TrueBlankSlate/TinyGPU/README.md

# TinyGPU

A small SIMD vector accelerator, attached to a [CVA6](https://github.com/openhwgroup/cva6) RISC-V core
as a custom coprocessor extension [(CV-X-IF)](https://docs.openhwgroup.org/projects/cva6-user-manual/01_cva6_user/CVX_Interface_Coprocessor.html), that runs 4x4 matrix operations
(`vmacc` matrix-multiply, `vadd.vv` elementwise add) on real Zynq-7000 hardware.
CVA6 issues vector-style instructions over the CV-X-IF interface; TinyGPU
decodes them, runs four ALU lanes in parallel, and writes results back to
memory over AXI.

It accepts 64-bit RISC-V Vector Extension standard instructions like `vle64.v vadd.vv vmacc.vv vse64.v `  
and operates like [ARA](https://github.com/pulp-platform/ara) in tandem with CVA6.

<p align ="center">
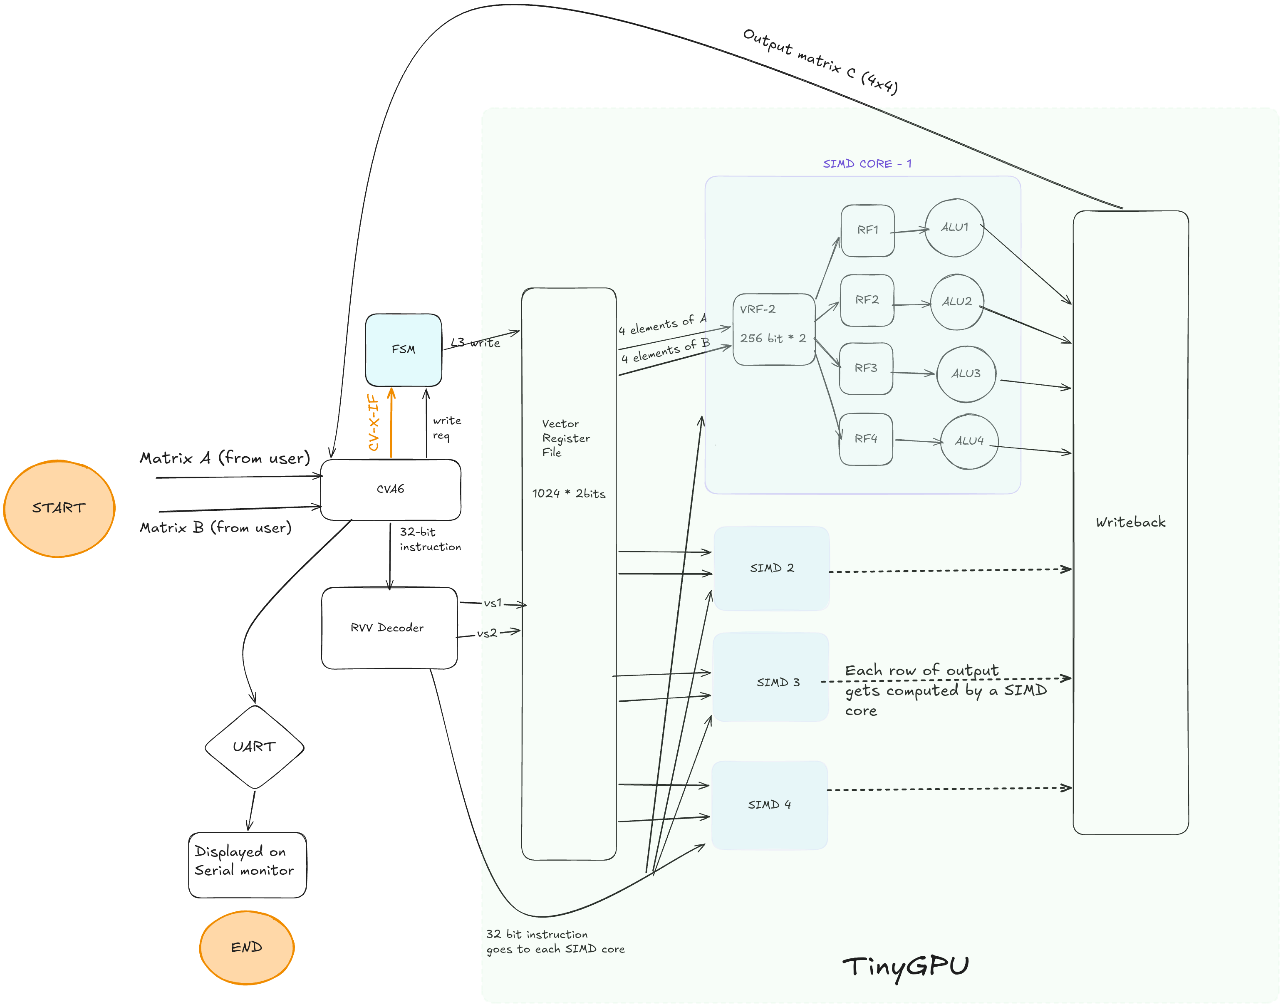
[picture p1: images/tinygpu_exacli.png]
Elaborated design

</p>

## Overview

TinyGPU is four ALU lanes (`design_1` / "the SIMD core") wrapped by a small
FSM (`tinygpu_fsm.v`) that:

- receives an offloaded instruction from CVA6 over CV-X-IF (`tinygpu_cvxif_wrap.v`,
  `cva6_sv_shim.sv`),
- pulls the operand matrices (`mat_a`, `mat_b`) into a 4-row/4-column
  register cache (`cache.v`, `register_file.v`),
- runs all 4 lanes' ALUs (`alu.v`) in parallel per pass, either as a plain
  elementwise op or, for `vmacc`, accumulating each lane's product into a
  dot-product term (`dot_reg[]` in `design_1.v`) across 4 passes to produce
  one row of a real matrix product,
- and drives an AXI4 write burst (`writeback.v`) to park the 4x4 result back
  in memory for the host to read.

The whole thing is built as a Zynq PS7 + custom PL design
(`zynq_system.bd`): CVA6 and TinyGPU live in the PL as `fpga_top`, boot
straight out of a synthesizable BRAM (`axi4_bram_slave.v`, preloaded via
`boot_image.hex`) instead of an OS, run a fixed instruction sequence (load
matrix A, `vmacc` A×A, store, `vadd.vv` A+A, store, loop), and the PS7's
ARM side (running a bare-metal Vitis app) reads the results straight out of
PL memory over the GP0 AXI port and prints them over UART.

### Workflow

1. On reset, CVA6 boots directly from `boot_image.hex` (no OS, no bootloader)
   and runs a short RISC-V program, compiled by a real `riscv64-unknown-elf-
   gcc`/`riscv-none-elf-gcc` toolchain from `fw/boot_matmul.S` (see
   [`fw/`](#fw--real-compiler-toolchain) below), that:
   - loads a 4x4 matrix `A` (64-bit elements) via a custom `vle64.v` load,
   - issues `vmacc` (matrix multiply, A × A) and stores the 4x4 result `C_mul`,
   - issues `vadd.vv` (elementwise add, A + A) and stores the 4x4 result `C_add`,
   - jumps to itself (`jal x0,0`) to park.
2. Every custom vector instruction is caught by CVA6's CV-X-IF offload
   interface and handed to TinyGPU instead of being executed on the scalar
   pipeline.
3. TinyGPU computes the result across 4 lanes/4 passes and writes it back
   over AXI4 to a fixed address in PL memory.
4. The Zynq PS7 (a bare-metal Vitis app, `vitis/main.c`) reads both result
   matrices straight out of that PL memory through the GP0 AXI aperture
   (`0x4000_0000`+) and prints them over UART:

   For vmacc.vv
   ```
   C_mul = A x A (vmacc)
   [   90  100  110  120 ]
   [  202  228  254  280 ]
   [  314  356  398  440 ]
   [  426  484  542  600 ]
   ```
   And for vadd.vv
   ```

   C_add = A + A (vadd.vv)
   [    2    4    6    8 ]
   [   10   12   14   16 ]
   [   18   20   22   24 ]
   [   26   28   30   32 ]
   ```

### Block design (Vivado)
<p align="center">
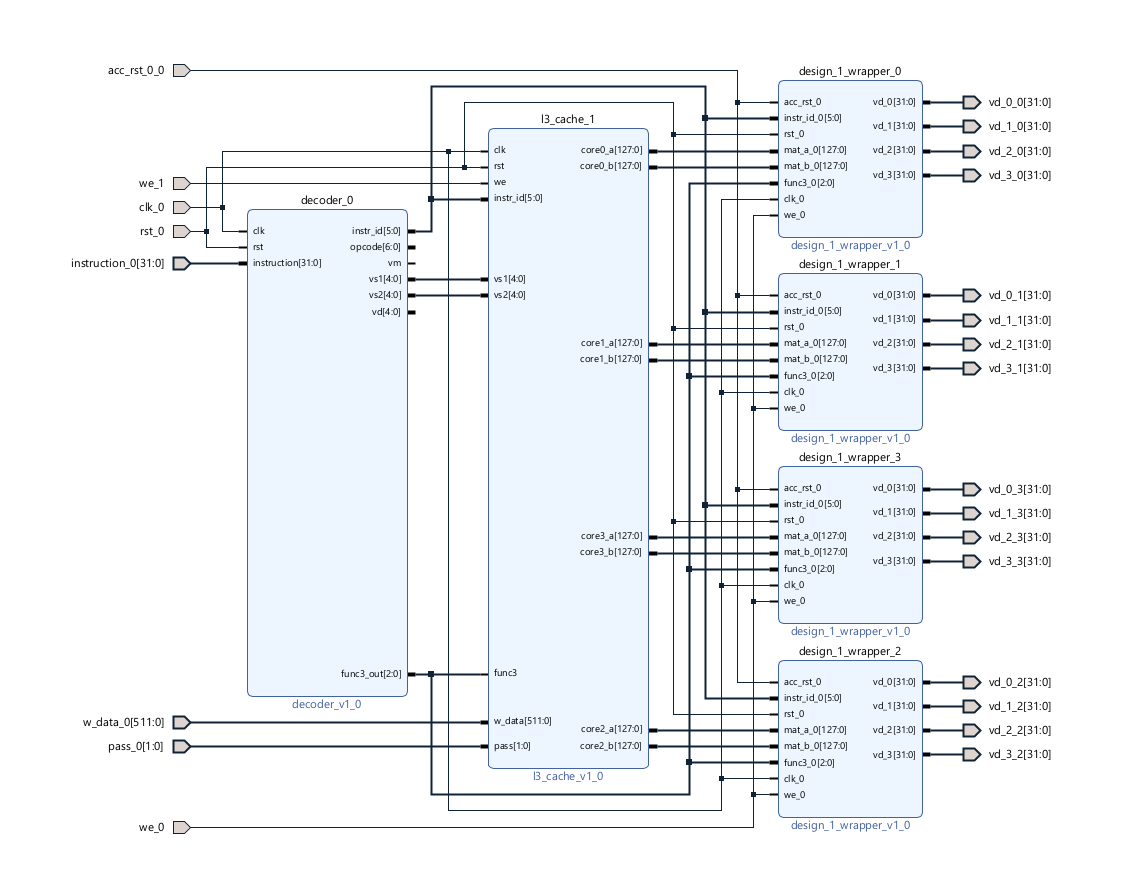
[picture p2: images/tinygpu_block_design.png]
Block Design
 </p>

PS7 is configured with the board preset, `M_AXI_GP0` enabled, and a 25MHz
FPGA clock. `fpga_top` is wired in as a plain RTL module (not packaged as an
IP), with GP0 connected **directly** to `axi4_bram_slave`'s AXI-lite-style
read port (no SmartConnect / interconnect in the datapath) so the PS7 can
read TinyGPU's result memory with the simplest possible address decode.

<p align="center">
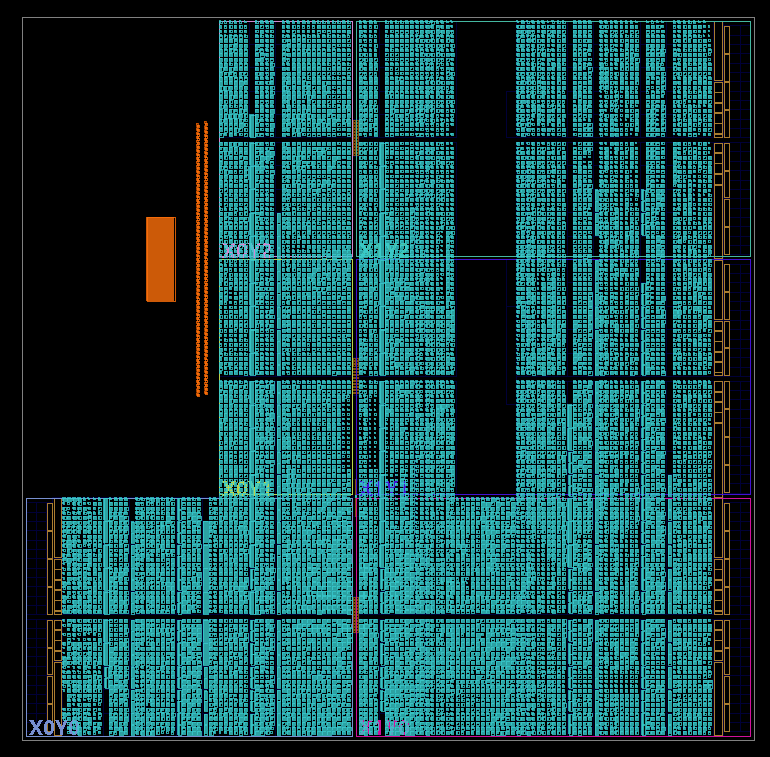
[picture p3: images/zynq_implemented_design.png]
Zynq Implemented design
</p>

### Simulation

The initial zero hold is for CVA6 to boot, and then there is the output from matrix multiplication which takes 4 cycles to complete  
and thenyou have matrix addition taking 1 cycle.

## Repo layout

```
boot_image.hex     -- $readmemh preload for axi4_bram_slave (real-hardware boot program).
                      Generated by fw/build.sh -- do not hand-edit, see fw/ below.
bench_image.hex    -- optional: fw/build.sh bench's output, boots the mcycle
                      benchmark instead of the plain demo -- see Benchmarking below.
build/             -- Vivado Tcl scripts (source these in order, see below)
fw/                -- real RISC-V toolchain source for boot_image.hex/bench_image.hex (see below)
src/rtl/
  cvxif/           -- CV-X-IF glue: AXI slaves, CVA6<->TinyGPU shim, dispatch FSM
  tinygpu/         -- TinyGPU core: ALU lanes, cache, register file, decoder, writeback
src/tb/            -- testbenches: tb_cva6_boot (main boot+matmul test, hand-pokes
                      instructions directly into memory), tb_boot_image (same test,
                      but $readmemh's the real boot_image.hex through the real
                      axi4_bram_slave.v -- verifies fw/'s compiler output),
                      tb_bench_image (same idea for bench_image.hex), tb_speedup_cycles
                      (sim-only scalar-vs-offload cycle count via internal probes)
vitis/             -- main.c for the PS7 bare-metal app (reads results, prints over UART)
```

### `fw/` -- real compiler toolchain

`boot_image.hex` used to be hand-spliced hex, instruction by instruction.
It's now a build artifact:

```
fw/boot_matmul.S    -- the boot program in real RISC-V assembly
fw/bench_matmul.S   -- csrr-mcycle-bracketed benchmark variant, see Benchmarking below
fw/link.ld          -- places .text at 0x8000_0000, matrix data at 0x8000_1000
fw/build.sh         -- runs the toolchain; `./build.sh` -> boot_image.hex,
                       `./build.sh bench` -> bench_image.hex
fw/elf2hex.py       -- converts the linked ELF into axi4_bram_slave.v's $readmemh format
```

Requires a `riscv64-unknown-elf-*`/`riscv-none-elf-*` GCC toolchain on
`PATH` (e.g. the [xPack GNU RISC-V Embedded
GCC](https://github.com/xpack-dev-tools/riscv-none-elf-gcc-xpack/releases)).
Run `CROSS_PREFIX=riscv-none-elf- ./fw/build.sh` (adjust the prefix to
match your toolchain's binary names) to regenerate `boot_image.hex`.

`boot_matmul.S` is deliberately compiled with `-march=rv64im` — **no**
`v` extension. TinyGPU's decoder repurposes real RVV opcode/funct3/funct6
bit patterns to mean matrix/cache-line IDs, not real per-lane
vector-register semantics governed by `vtype`/`vl` — letting the compiler
auto-generate a `vsetvli` or real vector code for this program would
silently compute the wrong thing. The 4 custom ops (`vle64.v`/`vmacc`/
`vadd.vv`/`vse64.v`) are emitted as verbatim `.word` literals in the
assembly instead; only the surrounding scalar glue (address setup via
`li`, the park loop) comes from the compiler. See `boot_matmul.S`'s header
comment for the full reasoning, and `src/rtl/cvxif/tinygpu_fsm.v`'s
`is_vec_arith` comment for the decoder-side half of this (a real
`vsetvli`, if one ever slipped in, now traps instead of corrupting state).

After rebuilding `boot_image.hex`, simulate `tb_boot_image` (not just
`tb_cva6_boot`, which never touches the file) before touching synthesis —
see `build/import_sources.tcl`'s notes on switching the sim top.

TinyGPU expects a sibling clone of CVA6 on disk, i.e.:

```
<parent>/
  TinyGPU/...      (this repo)
  CVA6/cva6/...    (https://github.com/openhwgroup/cva6)
```

`build/import_sources.tcl` computes both `repo_root` and `CVA6_ROOT` from its
own location (`[info script]`), so as long as the two repos are siblings this
works unmodified after a fresh clone anywhere. If your CVA6 clone lives
somewhere else, edit the one `CVA6_ROOT` line at the top of
`import_sources.tcl`.

### Benchmarking on hardware

**Spike does not apply here.** It's a functional RISC-V ISA simulator with
no timing model and no notion of the CV-X-IF interface or TinyGPU's SIMD
core -- it can't produce a cycle count, and can't even execute the custom
`vle64.v`/`vmacc`/`vse64.v` `.word`s without a bespoke plugin. Performance
has to be measured on the FPGA itself.

**Method: the RISC-V `mcycle` CSR (0xB00).** Confirmed implemented and
free-running on this CVA6 config (`cv64a6_imafdc_sv39`, `PerfCounterEn=1`,
`RVZicntr=1`); an M-mode read never traps. `fw/bench_matmul.S` runs
bare-metal in M-mode and brackets two back-to-back phases with `csrr`:

- **Scalar baseline** -- a real triple `i/j/k` loop computing `C_s = A x A`
  on CVA6's own RV64IM pipeline (real address arithmetic + branches, not an
  idealized unrolled loop). Window: first `ld` -> loop exit.
- **Offload** -- the same `vle64.v`/`vmacc`/`vse64.v`/`vadd.vv`/`vse64.v`
  sequence as `boot_matmul.S`. Window: issue `vle64.v` -> CV-X-IF commit of
  the last `vse64.v`. (CV-X-IF's `issue_ready = (FSM state == IDLE)`
  backpressure means CVA6 can't issue the *next* offloaded instruction
  until TinyGPU's FSM has cycled all the way back to `IDLE` -- so each AXI
  burst's protocol completion is structurally included in this window, not
  excluded.)

Both deltas land in BRAM (`0x8000_4000` scalar / `0x8000_4008` offload);
`vitis/main.c` reads them over the GP0 aperture and prints cycles, speedup,
and wall-clock time.

**Build and run:**
```bash
cd fw && CROSS_PREFIX=<your-prefix> ./build.sh bench   # -> ../bench_image.hex
```
Then simulate `src/tb/tb_bench_image.v` (`$readmemh`'s `bench_image.hex`
through the real `axi4_bram_slave.v`, checks results + both deltas,
`scalar_delta > offload_delta`) before touching synthesis. Cross-check the
scalar delta against `src/tb/tb_speedup_cycles.v`'s independent
`$time`-based `CVA6 matmul-only (first ld -> last add commit)` line --
expect a few cycles of difference (that program's scalar baseline is fully
unrolled with immediate-baked offsets, `bench_matmul.S`'s is a real loop),
not an order-of-magnitude one.

On hardware: flip `fpga_top.v`'s `axi4_bram_slave` `INIT_FILE` from
`"boot_image.hex"` to `"bench_image.hex"` (see the `*** MANUAL TOGGLE ***`
comment there), full OOC bitstream rebuild (`rebuild_launch.tcl`, never a
bare `reset_run`), re-export the `.xsa`, rebuild the Vitis app, boot, read
UART.

**Measured result (Zynq-7000, 25 MHz FCLK_CLK0):**
```
scalar  (CVA6 RV64IM, first ld -> last add)                : 1561 cycles
offload (TinyGPU vmacc+vadd, issue -> last vse64.v commit) : 100 cycles
speedup : 15.61x
@ 25 MHz FCLK_CLK0 : scalar 62.44 us, offload 4.00 us
```
This matches `tb_bench_image`'s simulated result bit-for-cycle -- the RTL
model is a faithful predictor of the silicon for this measurement.

**Known limits, not bugs:** the 4 ALU lanes are only active for 5 of those
100 offload cycles (4 `vmacc` passes + 1 `vadd.vv` pass, traced directly
from `tinygpu_fsm.v`'s `pass_q`/`we_0` logic) -- the rest is the `vle64.v`
32-beat read burst and two `vse64.v` 16-beat write bursts. Memory traffic
per offload is 512 bytes (`ar_len=31`, `aw_len=15`) against ~128-144
useful ops, i.e. arithmetic intensity around 0.25-0.28 ops/byte --
deeply memory-bound, as expected for a fixed 4x4 tile (compute scales N^3,
data movement N^2, so intensity scales ~N). This is also why TinyGPU's
15.6x here doesn't extrapolate to real vector-coprocessor numbers (e.g.
[Ara](https://github.com/pulp-platform/ara), CVA6 + a real RVV 1.0 unit,
reports ~70x on 128x128 matmul but only ~2x at 32x32): TinyGPU has no
`vtype`/`vl`-style reconfigurable vector length, so there's no dial to
turn for bigger problems the way a real vector unit has. Isolating the
pure ~4-cycle `vmacc` compute (FSM `COMPUTE -> result_valid`) instead of
software-visible latency needs an ILA on `tinygpu_fsm.v`'s `state`/
`pass_0`/`result_valid` and the CV-X-IF issue/commit handshake -- not set
up in this repo yet.

## How to build in Vivado

Tested with Vivado 2025.2, targeting a Zynq-7000 (`xc7z020clg484`, ZC702
board preset).

1. **Create a new RTL project** targeting board part `xilinx.com:zc702:part0:1.4`
   (or edit `build/build_zynq_bd.tcl` if targeting different hardware).
2. **Import sources** — open the Tcl console in Vivado and run:
   ```tcl
   source {<path-to-repo>/build/import_sources.tcl}
   ```
   This adds all CVA6 core files, all TinyGPU RTL/sim files, `boot_image.hex`
   (as a Memory Initialization File), and `build/fpga_top.xdc`, then sets
   `tb_cva6_boot` as the simulation top.
3. **Simulate first** (recommended, zero bitstream risk) — run behavioral
   simulation on `tb_cva6_boot` and confirm the matmul/add results land at
   the expected memory offsets before touching synthesis.
4. **Build the block design**:
   ```tcl
   source {<path-to-repo>/build/build_zynq_bd.tcl}
   source {<path-to-repo>/build/connect_gp0_direct.tcl}
   source {<path-to-repo>/build/finalize_bd.tcl}
   ```
   This creates the PS7 + `fpga_top` block design, wires GP0 directly to
   `fpga_top`'s AXI read port (no SmartConnect), generates the HDL wrapper,
   and sets it as the top module.
5. **Run synthesis, implementation, and generate the bitstream**:
   ```tcl
   source {<path-to-repo>/build/rebuild_launch.tcl}
   ```
   > **Important — out-of-context IP caching:** `fpga_top` lives inside
   > `zynq_system.bd` and gets its own cached out-of-context synthesis run,
   > separate from the top-level `synth_1`. If you ever change
   > `boot_image.hex` (or any file `fpga_top` depends on) and just
   > `reset_run synth_1`, Vivado may **not** notice the block design's
   > cached IP is stale and will silently reuse the old synthesized
   > `fpga_top`. `rebuild_launch.tcl` handles this correctly
   > (`reset_target all` + `generate_target all -force` on the `.bd` before
   > resetting `synth_1`) — always rebuild through it rather than
   > `reset_run`/`launch_runs` alone after touching a file `fpga_top` depends on.
6. `build/rebuild_check.tcl` re-runs a post-implementation utilization
   report if you need one.
7. **Export hardware** (Vivado: File → Export → Export Hardware, include
   bitstream) to produce the `.xsa` for Vitis.

## Vitis (host-side app)

1. Create a platform component from the exported `.xsa`, and an application
   component (standalone domain) pointing at that platform.
2. Copy `vitis/main.c` into the application component's `src/`.
3. Build the platform, then the application, program the device, open a
   serial terminal (UART, 115200 8N1 by default on this board), and reset
   the board — CVA6 reboots from `boot_image.hex` and the app prints
   `C_mul` and `C_add` as shown above.

If you change `boot_image.hex` or any RTL `fpga_top` depends on, you must
regenerate the bitstream (see the out-of-context caching note above),
**re-export hardware**, and rebuild the Vitis platform/application against
the fresh `.xsa` — an app built against a stale `.xsa` will boot the old
hardware even if the bitstream on disk is current.
