TrueBlankSlate/TinyGPU/images/elaborated_design.png

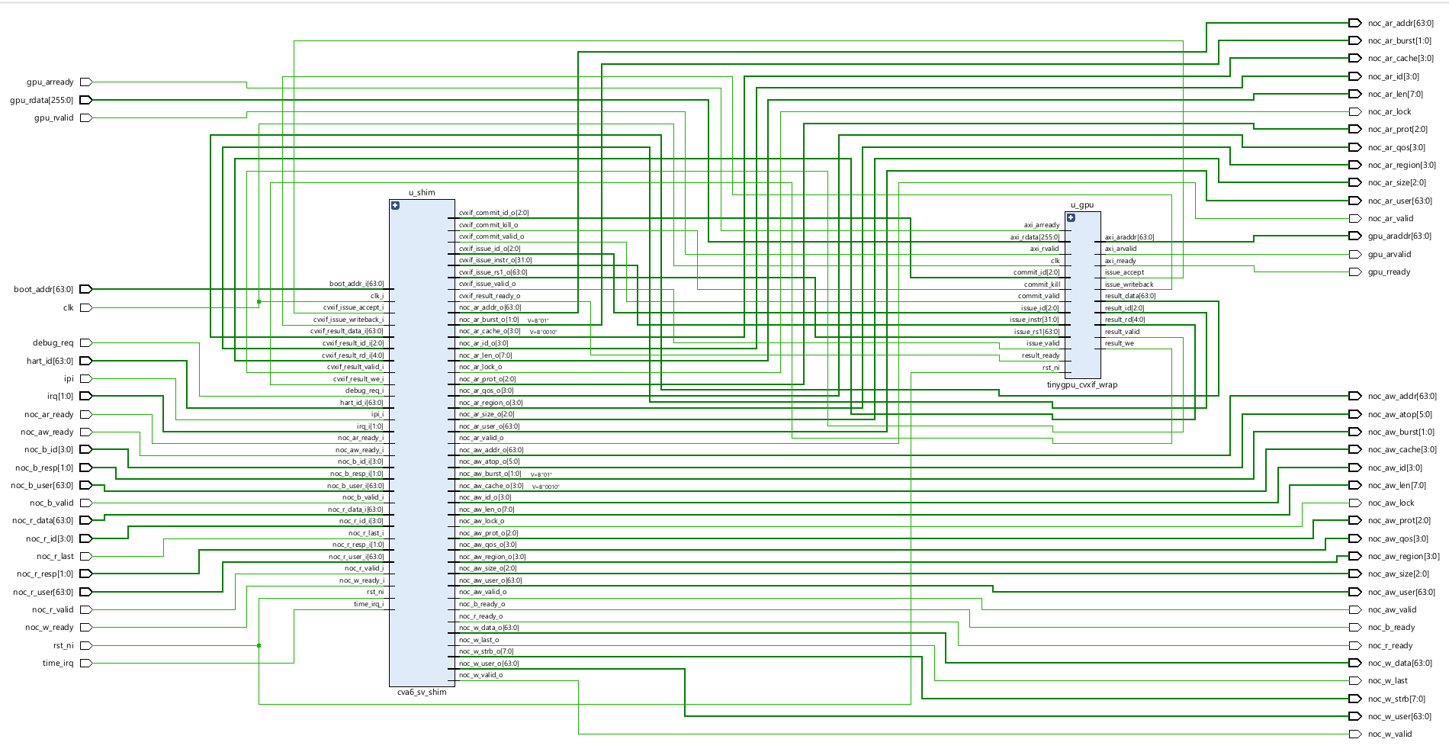
images/elaborated_design.png
