TrueBlankSlate/TinyGPU/src/rtl/tinygpu/register_file.v

module RegisterFile(
    input clk,
    input rst,
    input we,
    input [63:0] vs1_in,
    input [63:0] vs2_in,
    output reg [63:0] vs1_out,
    output reg [63:0] vs2_out
);

always @(posedge clk) begin
    if (rst) begin
        vs1_out <= 64'd0;
        vs2_out <= 64'd0;
    end
    else if (we) begin
        vs1_out <= vs1_in;
        vs2_out <= vs2_in;
    end
end
endmodule
