TrueBlankSlate/TinyGPU/src/rtl/tinygpu/tingpu_decoder.v

module tinygpu_decoder(
    input clk, rst,
    input  [31:0] instruction,
    output [6:0] opcode,
    output reg [5:0] instr_id,
    output reg vm,
    output reg [4:0] vs1,
    output reg [4:0] vs2,
    output reg [4:0] vd,
    output reg [2:0] func3_out
);

assign opcode = instruction[6:0];
wire [5:0] func6 = instruction[31:26];

always @(*) begin
    instr_id = 6'd0;
    vm = 1'b0;
    vs1 = 5'd0;
    vs2 = 5'd0;
    vd = 5'd0;
    func3_out  = instruction[14:12];

    if (opcode == 7'b1010111) begin
        case (func3_out)
            3'b000,3'b001,3'b010,3'b011,3'b100: begin
                instr_id = func6;
                vm = instruction[25];
                vs2 = instruction[24:20];
                vs1 = instruction[19:15];
                vd = instruction[11:7];
            end
            default: vd = 5'd0;
        endcase
    end else if (opcode == 7'b0000111) begin
        // vle64.v: custom two-destination bulk load, reuses the same
        // vs2/vs1 field positions as OP-V so one AXI fetch fills two
        // L3 cache lines (mat A and mat B) at once.
        vs2 = instruction[24:20];
        vs1 = instruction[19:15];
    end
end
endmodule
