TrueBlankSlate/TinyGPU/(commit log)

2026-08-29 Nest cvxif/ and rtl files under src/rtl/{cvxif,tinygpu}
    - cvxif/*.v,*.sv -> src/rtl/cvxif/
    - src/rtl/*.v (11 files) -> src/rtl/tinygpu/
    - import_sources.tcl: retarget rtl_dir/cvxif_dir to the new nested
    paths; also fix sim_dir (was src/sim, testbenches actually live in
    src/tb/) and update comments to match
    - README.md: update repo layout diagram and drop stale main/ path
    prefixes from the Vivado source commands (this repo's build/ lives
    at the repo root, not under a main/ subfolder)
    Verified via a stubbed tclsh run: all 220 CVA6 core files + 16 TinyGPU
    RTL files + 4 sim files resolve to real files on disk at their new
    locations, no missing paths.
    [alu.v, axi4_bram_slave.v, axi4_mem_slave.v, cache.v, cache_l3.v, cva6_sv_shim.sv, cva6_tinygpu_soc.v, design_1.v]
2026-09-01 fixed the output UART sequence. Output now comes one after another
    [design_1.v, tb_boot_image.v, tb_cva6_boot.v, tinygpu_fsm.v]
